hardenxiao2-maker/-/README.md

# 乒乓球位置控制实验装置

本项目是 2026 年佛山大学大学生电子设计竞赛 B 题“乒乓球位置控制实验装置”的完整实现。系统以 TI MSPM0G3507 为主控，通过 HC-SR04 测距、距离校准与 PID 闭环调节涡轮风机 PWM，使乒乓球在倾斜半圆导槽内稳定在设定位置；同时支持实体按键、OLED、ESP32 网页和 Android App 调试。

## 主要功能

- 30–70 cm 目标距离设定，实体按键以 5 cm 步长增减
- 超声波静态测距、温度补偿、多点分段线性校准和低通滤波
- PID 闭环风力控制，带基础 PWM、积分限幅、异常测距安全输出
- OLED 显示运行状态、目标距离、实际距离、PWM/RPM
- UART2 遥测和远程命令协议
- ESP32 自建热点网页监控，支持实时曲线和远程控制
- Android App 直连 WiFi/蓝牙串口透传模块，支持在线调参和校准

## 系统组成

```text
HC-SR04 ──> MSPM0G3507 ──PWM──> 风机驱动 ──> 乒乓球
                 │
                 ├── OLED / 按键
                 └── UART2 ──> ESP32 ──> 网页或 Android App
```

## 仓库结构

```text
firmware/mspm0/       MSPM0G3507 CCS/SysConfig 工程和驱动
esp32/web_bridge/     ESP32 热点、网页服务器和 UART 桥接程序
android/              Android App 源码及可安装 APK
docs/problem/         B 题题目原文
docs/guides/          程序、调参、无线通信和调试说明
videos/               题目 1～4 实机演示视频
```

## 演示视频

| 项目 | 功能 | 核心指标 | 演示 |
| --- | --- | --- | --- |
| 题目 1 | 静态距离检测 | 绝对误差 ≤ 2 cm，显示稳定 | [观看视频](videos/题目1.mp4) |
| 题目 2 | 手动距离调节 | 两个独立按键，每次调节 5 cm | [观看视频](videos/题目2.mp4) |
| 题目 3 | 闭环定点稳态控制 | 30～70 cm 定位，具备抗倾角扰动能力 | [观看视频](videos/题目3.mp4) |
| 题目 4 | 远程智能控制与可视化 | 远程增减距离，实时显示距离和占空比 | [观看视频](videos/题目4.mp4) |

视频内容和文件校验值见 [演示视频说明](videos/README.md)。

## 题目 1～4 内容与要求

以下要求根据仓库内的 [B 题原始赛题 PDF](docs/problem/B题-乒乓球位置控制实验装置-2026佛山大学电子设计竞赛题目%281%29.pdf) 整理。

### 题目 1：静态距离检测功能

- 将半圆导槽水平放置，风机保持关闭。
- 在导槽有效行程内任意放置乒乓球。
- 实时采集并数码显示乒乓球中心与超声波测距传感器之间的直线距离。
- 测量绝对误差不超过 2 cm。
- 数据刷新应稳定，无明显跳变。
- [观看题目 1 演示视频](videos/题目1.mp4)

### 题目 2：手动距离调节功能

- 将导槽倾斜放置，风机端位于低处，超声波传感器端位于高处。
- 启动风机后，乒乓球应脱离风机端口并悬浮在导槽内。
- 使用两个独立功能按键分别增加、减小目标距离。
- 每次增加或减小的距离为 5 cm，按键触发应灵敏。
- 乒乓球的悬浮定位区间应能自由调整；稳定时间越短、定位误差越小越好。
- [观看题目 2 演示视频](videos/题目2.mp4)

### 题目 3：闭环定点稳态控制功能

- 通过按键设定目标定位距离，设定范围为 30～70 cm。
- 使用闭环算法实时调节涡轮风机转速，使乒乓球中心稳定在设定距离。
- 人为小幅改变导槽倾斜角度后，装置应自动调整风速并保持设定值。
- 调节过程中不应出现明显偏移、坠落或飞出，需具备良好的抗干扰稳态控制能力。
- [观看题目 3 演示视频](videos/题目3.mp4)

### 题目 4：远程智能控制与可视化监测

- 至少采用串口、蓝牙、WiFi 或网络中的一种有线/无线通信方式。
- 支持手机或电脑终端远程控制。
- 可远程下发增加距离和减小距离指令。
- 实时上传乒乓球位置数据和风机运行占空比。
- 在上位终端实时显示距离与占空比。
- [观看题目 4 演示视频](videos/题目4.mp4)

## 硬件与接口

| 功能 | 接口 |
| --- | --- |
| HC-SR04 Trig / Echo | PB12 / PB13 |
| 风机 PWM | PA16、PA17（TIMA1） |
| 风机转速反馈 | PB7 |
| 目标距离减小 / 增加 | PB25 / PA29 |
| 启动 / 待机 | PB26 |
| OLED | I2C |
| UART2 TX / RX | PB15 / PA22，115200 baud |

实际接线和供电注意事项见 [调试方法](docs/guides/调试方法.md)。

## 快速开始

### 1. MSPM0 固件

1. 安装 Code Composer Studio、MSPM0 SDK 2.5.1.00、SysConfig 1.24.0 和 TI Clang 4.0.0 LTS。
2. 在 CCS 中导入 `firmware/mspm0`。
3. 打开 `empty.syscfg` 检查引脚和外设配置。
4. 编译并下载到 MSPM0G3507。
5. 首次带风机运行前，先按 [调试方法](docs/guides/调试方法.md) 完成静态测距、基础风量和 PID 调整。

### 2. ESP32 网页监控

1. 在 Arduino IDE 安装 ESP32 开发板支持和 `arduinoWebSockets` 库。
2. 打开并烧录 `esp32/web_bridge/esp32_web_bridge.ino`。
3. 连接热点 `PingPongCtrl`（示例密码 `12345678`）。
4. 浏览器访问 `http://192.168.4.1`。

完整说明见 [ESP32 网页调试说明](docs/guides/功能4_ESP32_WIFI网页调试说明.md)。

### 3. Android App

- 安装包：`android/release/PingPongCtrl.apk`
- 源码：用 Android Studio 打开 `android`，需要 Android SDK 35，最低支持 Android 6.0（API 23）。
- App 默认面向 `192.168.1.1:2001` 的串口透传模块；IP 和端口可在界面修改。

完整说明见 [Android App 调试说明](docs/guides/功能4_Android_APP调试说明.md)。

## 串口协议

MSPM0 周期上传：

```text
T,ms,active,target_cm,current_cm,pwm
```

远程端可发送 `RUN`、`STOP`、`UP`、`DOWN`、`SET 50`、`GET`，也可使用 `CFG,...` 和 `CAL,...` 命令在线修改参数与校准表。协议细节见 [参数调节功能说明](docs/guides/参数调节功能说明.md)。

## 发布说明

- 本仓库只保留 B 题可复现内容；SDK、IDE、供应商工具包、编译缓存、备份文件、H 题和其他历史项目均未收录。
- ESP32 和 App 中的密码均为演示默认值，部署时请修改。

## License

[MIT](LICENSE)
