hardenxiao2-maker/-/videos/README.md

# 实机演示视频

本目录收录 B 题装置题目 1～4 的四段 MP4 实机演示。各视频对应的赛题要求如下：

| 文件 | 对应内容 | 关键要求 | 大小 | SHA-256 |
| --- | --- | --- | ---: | --- |
| [题目1.mp4](题目1.mp4) | 静态距离检测 | 风机关闭；绝对误差 ≤ 2 cm；显示稳定 | 10.04 MiB | `1E673638BEDE915F4C5A74064899001360A6057781F0A1C9685732721A1A1C89` |
| [题目2.mp4](题目2.mp4) | 手动距离调节 | 两个独立按键；每次增减 5 cm | 19.12 MiB | `E245DB2DDECB3296233C70188497C2F1E0F0A15B40D6956067D23D6BF256EB63` |
| [题目3.mp4](题目3.mp4) | 闭环定点稳态控制 | 30～70 cm 定位；小幅改变倾角后保持稳定 | 6.25 MiB | `5AE0B8E2174F7C47089E5E4A81A353E1D64E61861AC74D0D416433C276945948` |
| [题目4.mp4](题目4.mp4) | 远程智能控制与可视化 | 远程增减距离；实时上传并显示距离、占空比 | 9.93 MiB | `EE02DFAB97AB27338903F587207D47F053E76B48411B002B709DC2402086155D` |

完整条目和分值说明见项目首页的[题目 1～4 内容与要求](../README.md#题目-14-内容与要求)。
