hardenxiao2-maker/-/(commit log)

2026-08-13 整理并发布 B 题乒乓球位置控制装置
2026-08-13 添加 B 题四项实机演示视频
2026-08-13 补充题目一至四内容与验收要求
